touchtechio/spiderdress/eagle/spiderBoardv17-2014-12-18.xls

Bill of Materials - Per Board |  |  |  |  | Customer Info | Matt Pinner | matthewx.pinner@intel.com | Cell: 310-866-0521
Order No |  |  |  |  |  | Attn: Todd Harple
Part No |  | Mpinner-spider-v17 |  |  |  | 2501 NW 229th Ave, RS5-250
 |  |  |  |  |  | Hillsboro, OR, 97124
Item # | Qty | Ref Des | Value | Manufacturer | Mfg Part Num | Distributor | Dist Part # | Description | Package | Type
1 | 1 | R1 | 1k | Vishay Dale | ERJ-3GEYJ102V | Digikey | P1.0KGCT-ND | Resistor | 0603 | smt
2 | 16 | R2,R4,R5,R6,R7,R8,R9,R10,R12,R14,R15,R16,R17,R18,R19,R21 | 10k | Panasonic | ERJ3GEYJ103V | Digikey | P10KGCT-ND | Resistor | 0603 | smt
3 | 1 | C1 | 1uF | Samsung | CL10F105ZP8NNNC | Digikey | 1276-1041-1-ND | Capacitor | 0603 | smt
4 | 1 | U1 | ADS1115 | TI | ADS1115IDGST | Digikey | 296-24934-1-ND | ADC_ADS1015 | MSOP10 | smt
5 | 3 | U2,U3,U4 | DUAL_N-CH_MOSFET | Diodes | BSS138DW-7-F | Digikey | BSS138DW-FDICT-ND | DUAL_N-CH_MOSFET | SOT-363 | smt
6 | 1 | U6 | DNP | intel | na | na | na | na | na | DNP
7 | 4 | U7 | DNP | pololu | 5V_500MA_REG | Pololu | 5V_500MA_REG | 5V_500MA_REG | na | DNP
8 | 1 | U8 | DF40 | hirose | DF40C-70DS-0.4V | Digikey | H11631CT-ND | edison 2mm connector | df40 | smt
 |  |  |  |  |  |  |  | BOARD SUMMARY FOR QUOTE
 |  |  |  |  |  |  |  | Total # of unique parts | 6
 |  |  |  |  |  |  |  | SMT placements per board | 23
 |  |  |  |  |  |  |  | Thru-hole placements per board | 0
 |  |  |  |  |  |  |  | Fine pitch placements per board | 0
 |  |  |  |  |  |  |  | BGA/QFN/Leadless placements per board | 0
 |  |  |  |  |  |  |  | * DNP: Do Not Place
