touchtechio/spiderdress/eagle/buckpuckV5_2014-12-10.brd

## EAGLE design eagle/buckpuckV5_2014-12-10.brd (2015-01-24)

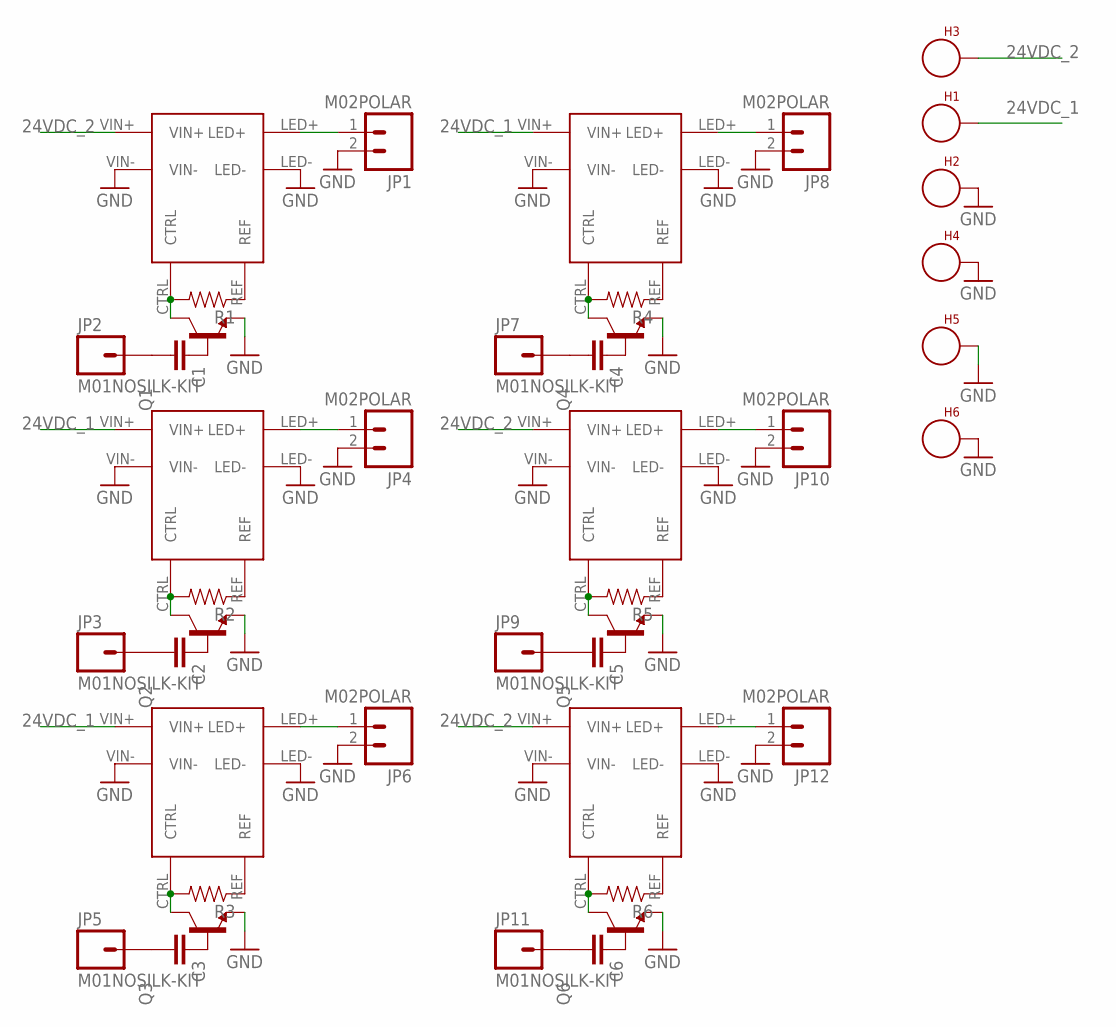
[picture p2: schematic buckpuckV5_2014-12-10.sch]

Parts:
C1, C2, C3, C4, C5, C6: CAPEZ; CAP-PTH-SMALLEZ
H1, H2, H3, H4, H5, H6: SEW_HOLE; SIMPLE_HOLE
JP1, JP4, JP6, JP8, JP10, JP12: M02POLAR; MOLEX-1X2
JP2, JP3, JP5, JP7, JP9, JP11: M01NOSILK-KIT; 1X01NS-KIT
Q1, Q2, Q3, Q4, Q5, Q6: TRANSISTOR_BJT_NPN-TO-92-EBC; TO-92
R1, R2, R3, R4, R5, R6: RESISTOREZ; AXIAL-0.3EZ
U$1, U$2, U$3, U$4, U$5, U$6: BUCKPUCK

Connections:
24VDC_1: H1.P$1, U$2.VIN+, U$3.VIN+, U$4.VIN+
24VDC_2: H3.P$1, U$1.VIN+, U$5.VIN+, U$6.VIN+
GND: H2.P$1, H4.P$1, H5.P$1, H6.P$1, JP1.2, JP4.2, JP6.2, JP8.2, JP10.2, JP12.2, Q1.1 (E), Q2.1 (E), Q3.1 (E), Q4.1 (E), Q5.1 (E), Q6.1 (E), U$1.LED-, U$1.VIN-, U$2.LED-, U$2.VIN-, U$3.LED-, U$3.VIN-, U$4.LED-, U$4.VIN-, U$5.LED-, U$5.VIN-, U$6.LED-, U$6.VIN-
unnamed: R1.P$1 (1), U$1.REF
unnamed: Q1.3 (C), R1.P$2 (2), U$1.CTRL
unnamed: C1.1, Q1.2 (B)
unnamed: R4.P$1 (1), U$4.REF
unnamed: JP1.1, U$1.LED+
unnamed: C1.2, JP2.1
unnamed: C2.1, Q2.2 (B)
unnamed: Q2.3 (C), R2.P$2 (2), U$2.CTRL
unnamed: C4.1, Q4.2 (B)
unnamed: C3.1, Q3.2 (B)
unnamed: JP4.1, U$2.LED+
unnamed: C2.2, JP3.1
unnamed: C6.1, Q6.2 (B)
unnamed: Q3.3 (C), R3.P$2 (2), U$3.CTRL
unnamed: Q4.3 (C), R4.P$2 (2), U$4.CTRL
unnamed: JP6.1, U$3.LED+
unnamed: C3.2, JP5.1
unnamed: R2.P$1 (1), U$2.REF
unnamed: C5.1, Q5.2 (B)
unnamed: R5.P$1 (1), U$5.REF
unnamed: R3.P$1 (1), U$3.REF
unnamed: JP8.1, U$4.LED+
unnamed: C4.2, JP7.1
unnamed: R6.P$1 (1), U$6.REF
unnamed: Q5.3 (C), R5.P$2 (2), U$5.CTRL
unnamed: JP10.1, U$5.LED+
unnamed: C5.2, JP9.1
unnamed: Q6.3 (C), R6.P$2 (2), U$6.CTRL
unnamed: JP12.1, U$6.LED+
unnamed: C6.2, JP11.1

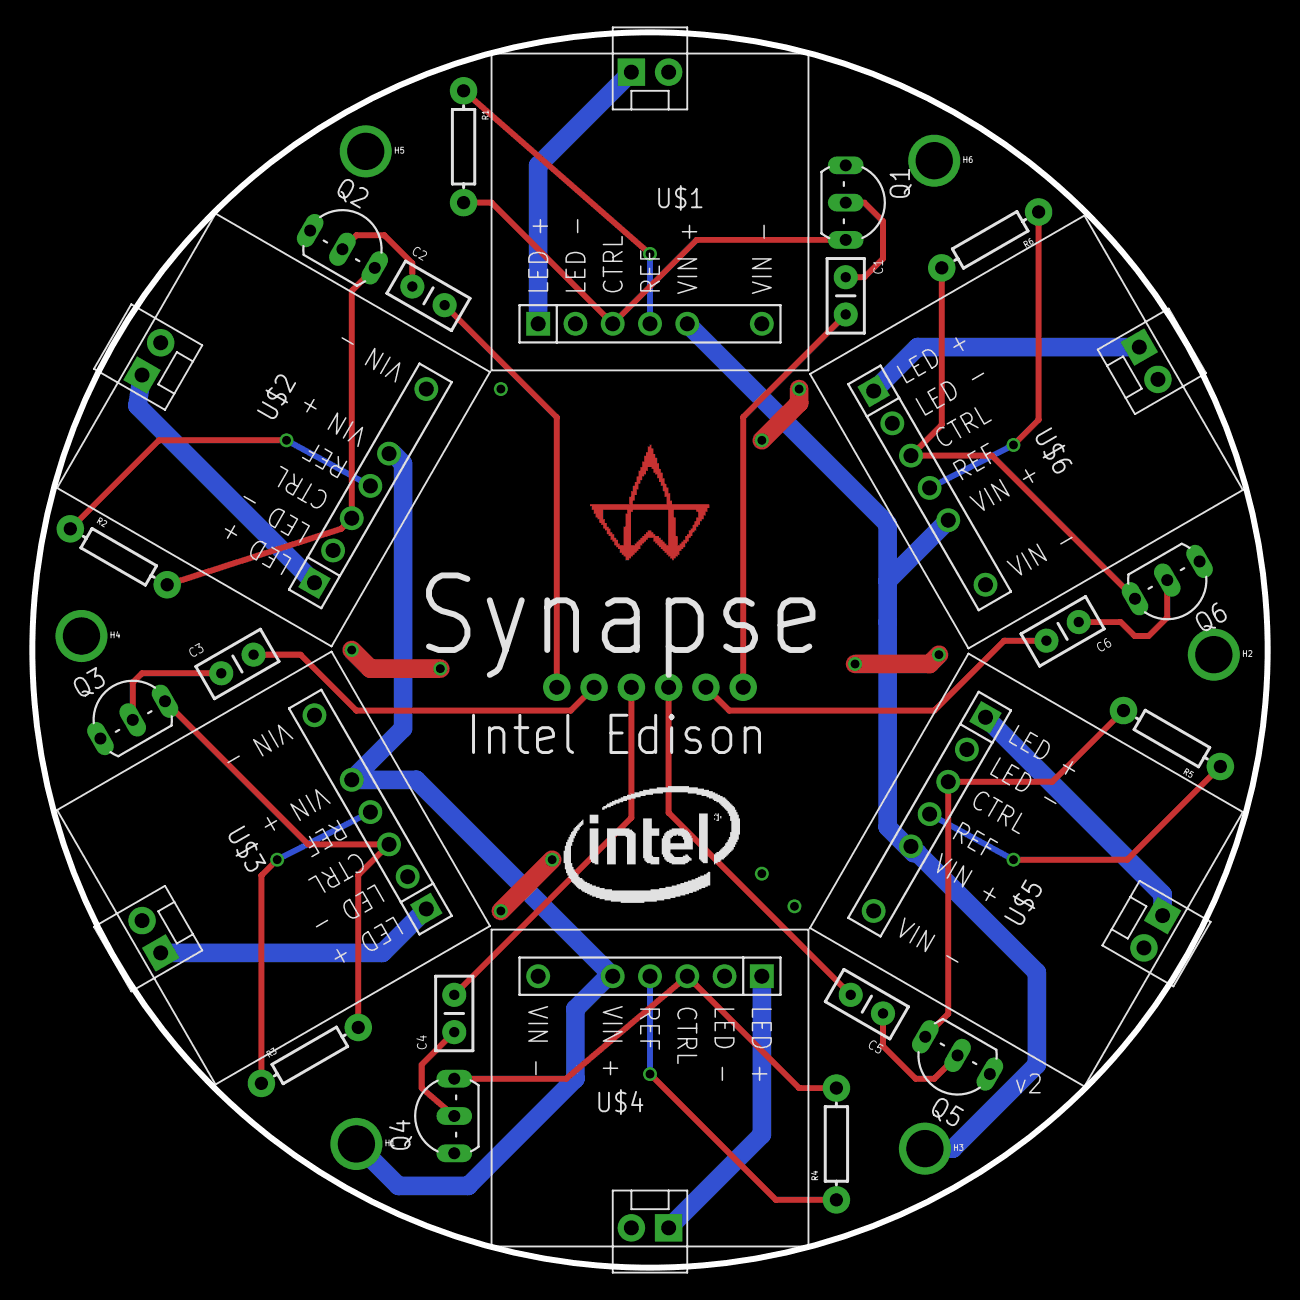
[picture p3: board buckpuckV5_2014-12-10.brd from above]

Board: 2 copper layers, 84.2 x 84.2 mm, 44 parts (1 on the bottom side), 33 nets.

Other parts of the board:
U$7: NOUKLOGO3IN
U$8: NOUKLOGO300MIL_COPPER
