touchtechio/spiderdress/eagle/spiderBoardv17-2014-12-18.brd

## EAGLE design eagle/spiderBoardv17-2014-12-18.brd (2015-01-24)

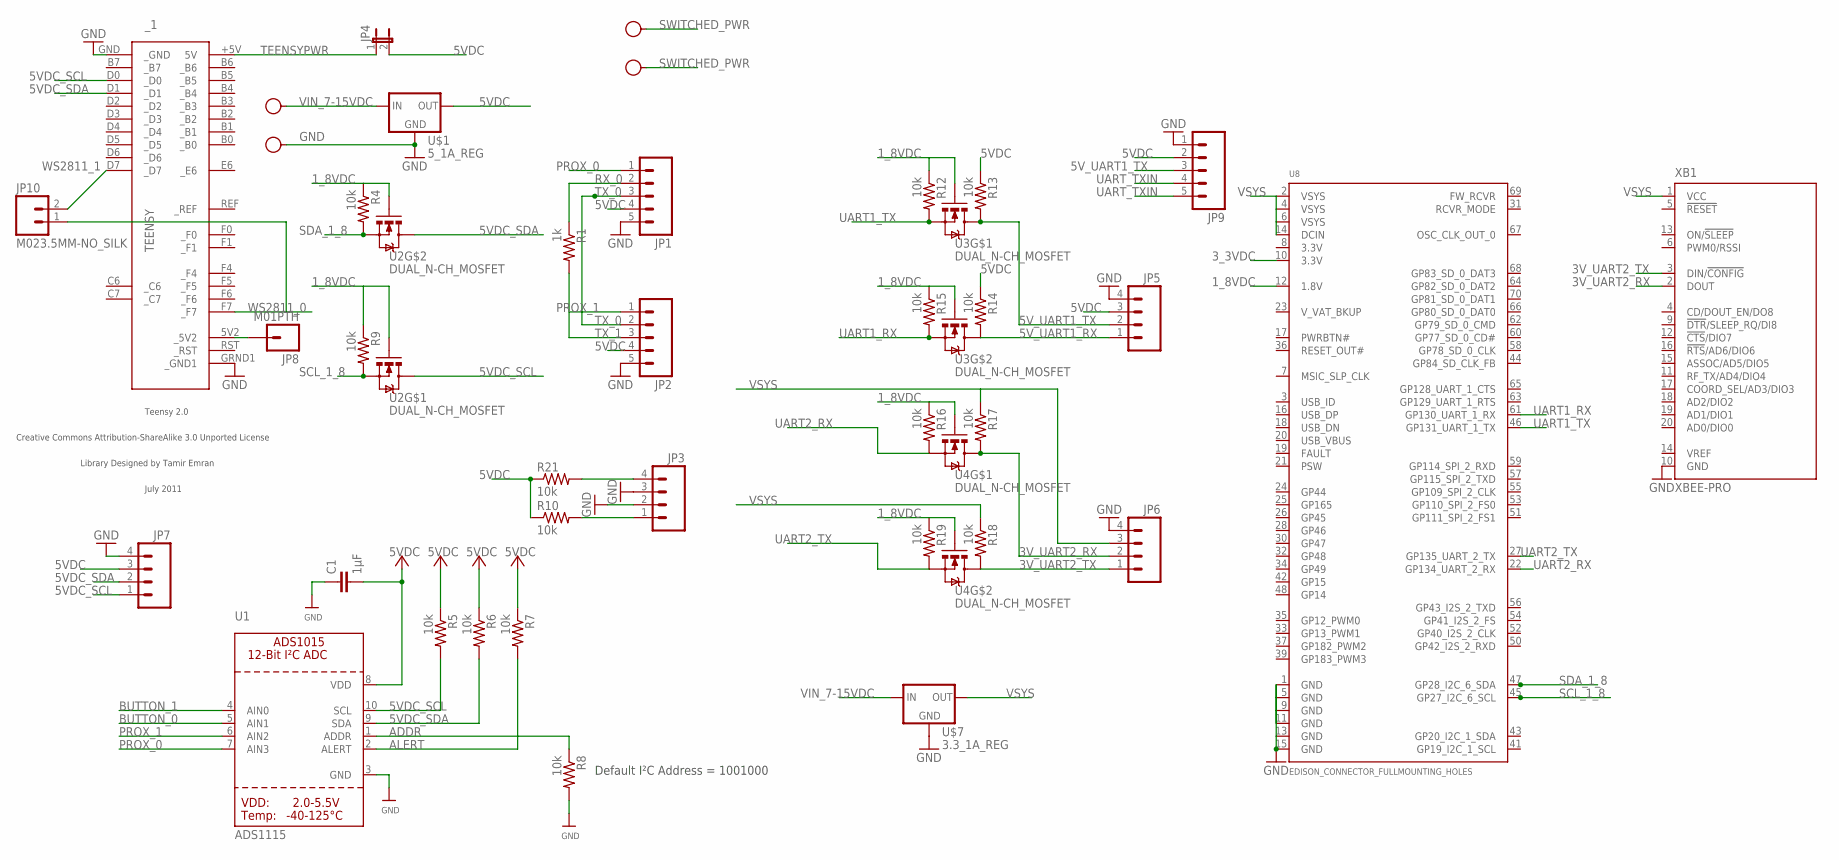
[picture p4: schematic spiderBoardv17-2014-12-18.sch]

Parts:
C1: 1µF; 0603-CAP
GND, GND15: SEW_HOLE-SMALL; SIMPLE_HOLE_SM
JP1, JP2, JP9: M05PTH; 1X05
JP3, JP5, JP6, JP7: M04PTH; 1X04
JP4: JUMPER-2SMD-NC; SJ_2S
JP8: M01PTH; 1X01
JP10: M023.5MM-NO_SILK; SCREWTERMINAL-3.5MM-2-NS
R1: 1k; 0603-RES
R4, R5, R6, R7, R8, R9, R10, R12, R13, R14, R15, R16, R17, R18, R19, R21: 10k; 0603-RES
U1: ADS1115; MSOP10
U2, U3, U4: DUAL_N-CH_MOSFET; SOT363_DUAL_N_MOSFET
U8: EDISON_CONNECTOR_FULLMOUNTING_HOLES; EDISON_DAUGHTER
U$1: 5_1A_REG; 1A_REG
U$7: 3.3_1A_REG; 1A_REG
VIN_7-15VDC, VIN_7-15VDC1: SEW_HOLE-SMALL; SIMPLE_HOLE_SM
XB1: XBEE-PRO
_1: TEENSY

Connections:
1_8VDC: R4.1, R9.1, R12.1, R15.1, R16.1, R19.1, U2.2 (G), U2.5 (G), U3.2 (G), U3.5 (G), U4.2 (G), U4.5 (G), U8.12 (1.8V)
3V_UART2_RX: JP6.2, R17.2, U4.3 (D), XB1.2 (DOUT)
3V_UART2_TX: JP6.1, R18.2, U4.6 (D), XB1.3 (DIN/!CONFIG)
3_3VDC: U8.10 (3.3V)
5VDC: C1.2, JP1.4, JP2.4, JP4.2, JP5.3, JP7.3, JP9.2, R5.1, R6.1, R7.1, R10.1, R13.1, R14.1, R21.1, U1.8 (VDD), U$1.OUT
5VDC_SCL: JP7.1, R5.2, U1.10 (SCL), U2.3 (D), _1.D0 (_D0)
5VDC_SDA: JP7.2, R6.2, U1.9 (SDA), U2.6 (D), _1.D1 (_D1)
5V_UART1_RX: JP5.1, R14.2, U3.6 (D)
5V_UART1_TX: JP5.2, JP9.3, R13.2, U3.3 (D)
ADDR: R8.1, U1.1 (ADDR)
ALERT: R7.2, U1.2 (ALERT)
BUTTON_0: JP3.4, R21.2, U1.5 (AIN1)
BUTTON_1: JP3.1, R10.2, U1.4 (AIN0)
GND: C1.1, GND.P$1, JP1.5, JP2.5, JP3.2, JP3.3, JP5.4, JP6.4, JP7.4, JP9.1, R8.2, U1.3 (GND), U8.1 (GND), U8.5 (GND), U8.9 (GND), U8.11 (GND), U8.13 (GND), U8.15 (GND), U$1.GND, U$7.GND, XB1.10 (GND), _1.GND (_GND), _1.GRND1 (_GND1)
PROX_0: JP1.1, U1.7 (AIN3)
PROX_1: JP2.1, U1.6 (AIN2)
RX_0: JP1.2, R1.1
SCL_1_8: R9.2, U2.4 (S), U8.45 (GP27_I2C_6_SCL)
SDA_1_8: R4.2, U2.1 (S), U8.47 (GP28_I2C_6_SDA)
SWITCHED_PWR: GND15.P$1, VIN_7-15VDC1.P$1
TEENSYPWR: JP4.1, JP8.1, _1.5V2 (_5V2), _1.+5V (5V)
TX_0: JP1.3, JP2.2
TX_1: JP2.3, R1.2
UART1_RX: R15.2, U3.1 (S), U8.61 (GP130_UART_1_RX)
UART1_TX: R12.2, U3.4 (S), U8.46 (GP131_UART_1_TX)
UART2_RX: R16.2, U4.4 (S), U8.22 (GP134_UART_2_RX)
UART2_TX: R19.2, U4.1 (S), U8.27 (GP135_UART_2_TX)
UART_TXIN: JP9.4, JP9.5
VIN_7-15VDC: U$1.IN, U$7.IN, VIN_7-15VDC.P$1
VSYS: JP6.3, R17.1, R18.1, U8.2 (VSYS), U8.4 (VSYS), U8.6 (VSYS), U8.14 (DCIN), U$7.OUT, XB1.1 (VCC)
WS2811_0: JP10.1, _1.F7 (_F7)
WS2811_1: JP10.2, _1.D7 (_D7)

Notes on the sheet:
Default I²C Address = 1001000

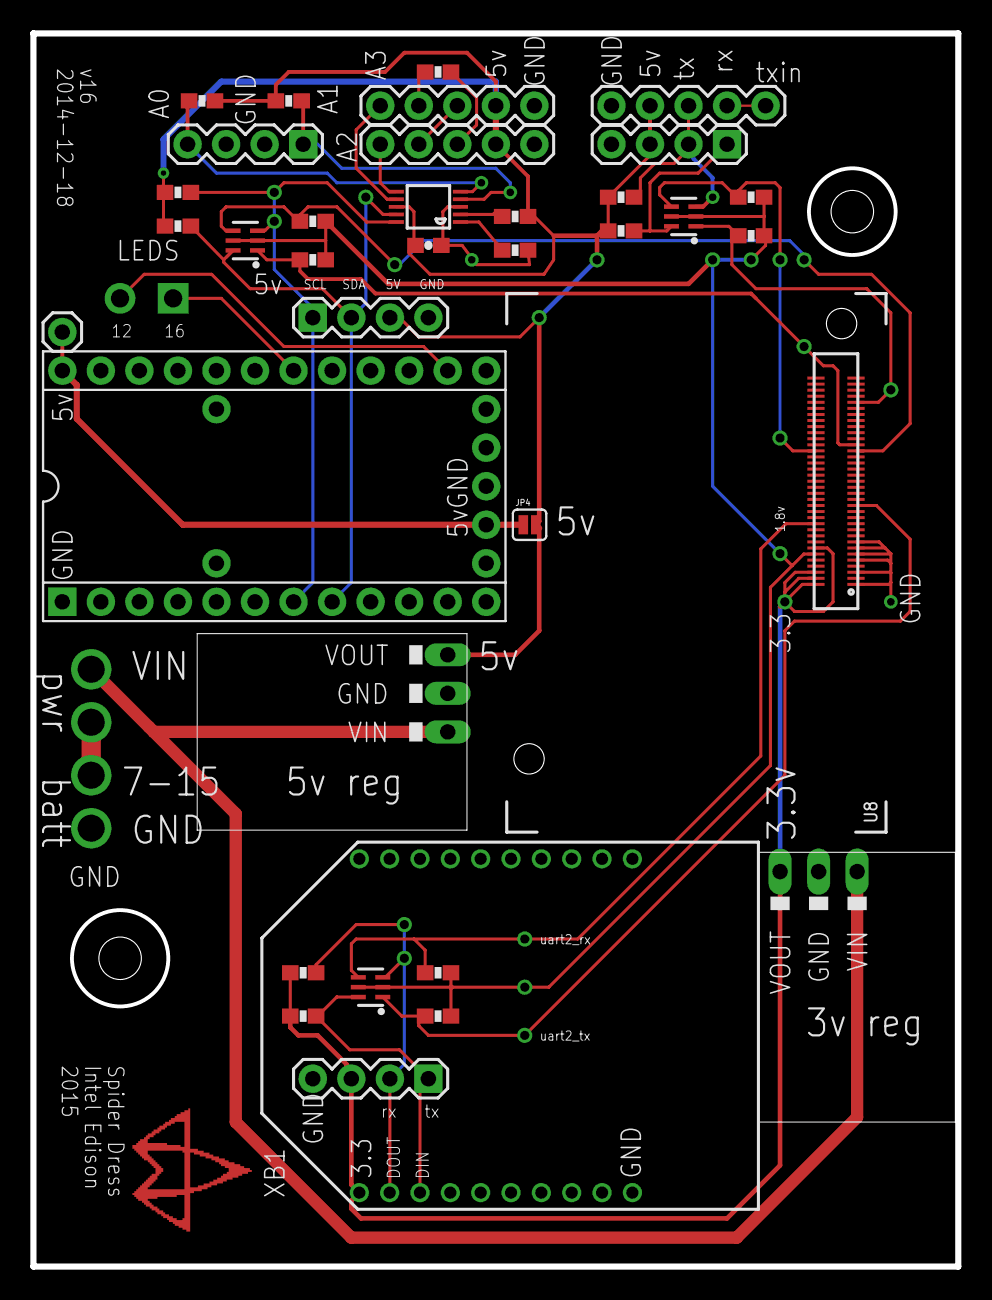
[picture p5: board spiderBoardv17-2014-12-18.brd from above]

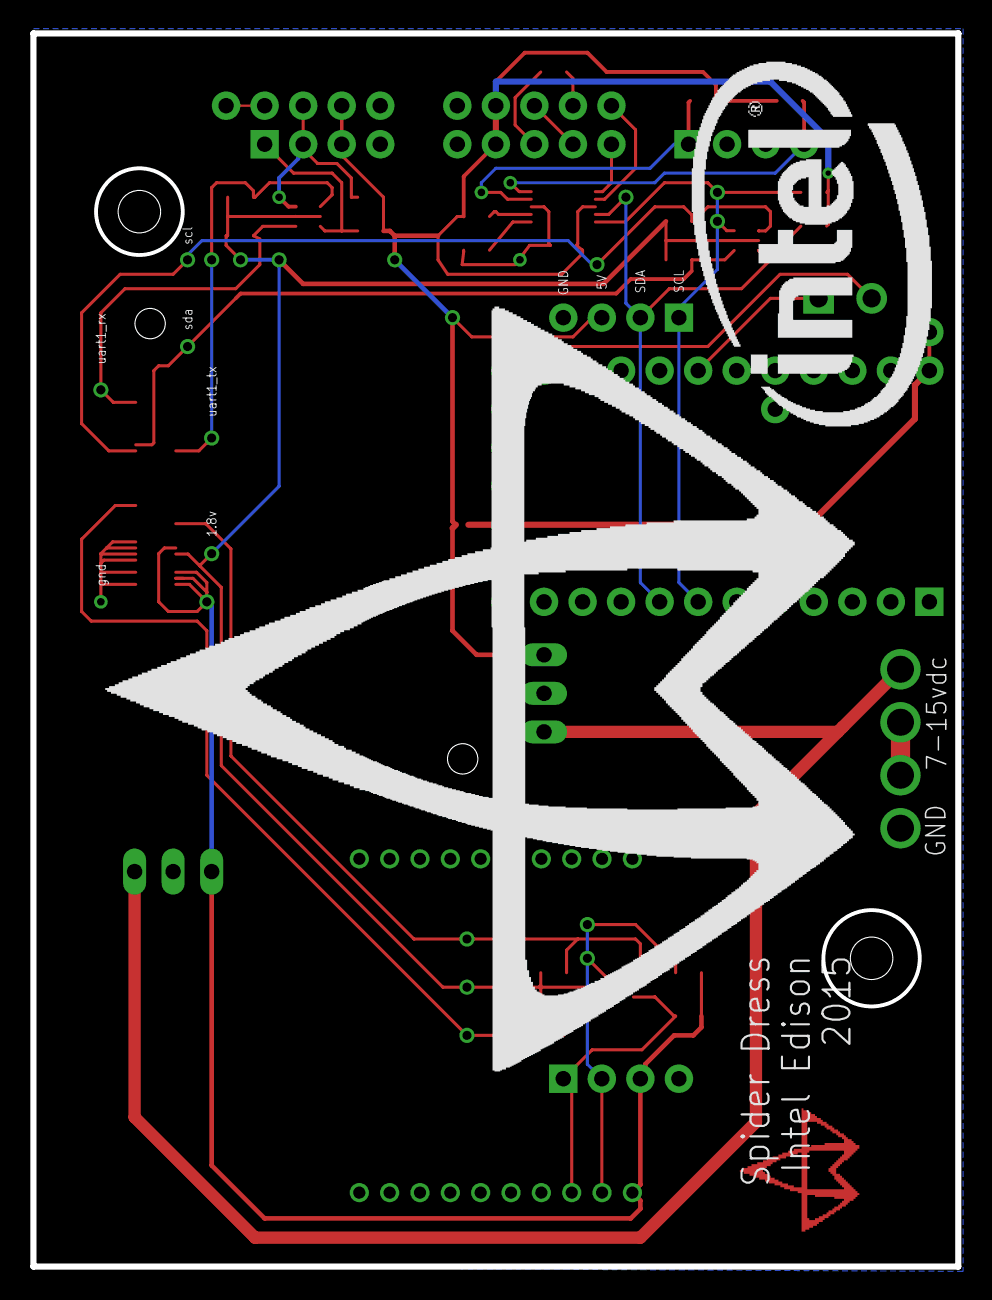
[picture p6: board spiderBoardv17-2014-12-18.brd from below]

Board: 2 copper layers, 61.0 x 81.3 mm, 44 parts (2 on the bottom side), 31 nets.

Other parts of the board:
U$9: NOUK-800
U$11: NOUKLOGO300MIL_COPPER
U$12: INTEL_1IN
