touchtechio/spiderdress/eagle/commonBoard.brd

## EAGLE design eagle/commonBoard.brd (2014-11-17)

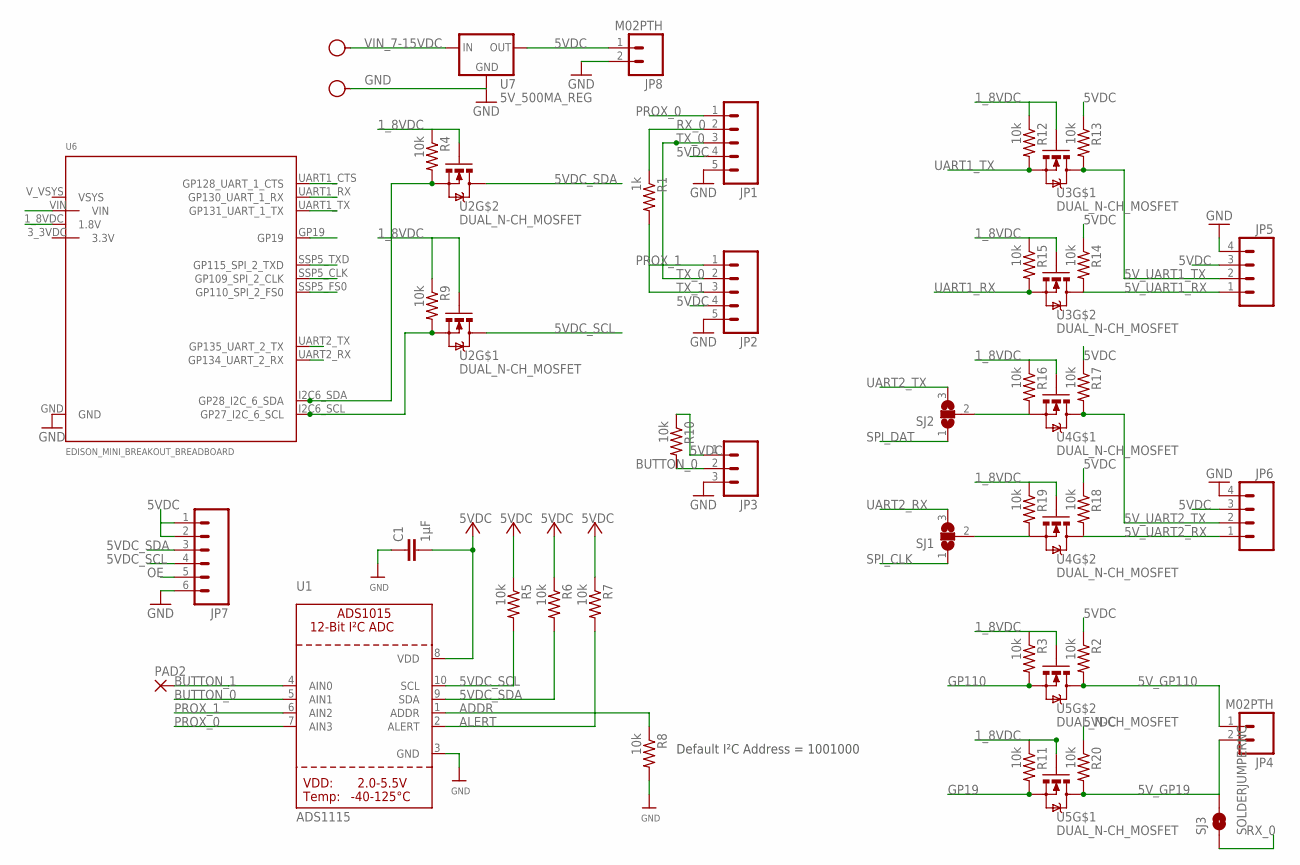
[picture p7: schematic commonBoard.sch]

Parts:
C1: 1µF; 0603-CAP
GND: SEW_HOLE-SMALL; SIMPLE_HOLE_SM
JP1, JP2: M05PTH; 1X05
JP3: M03PTH; 1X03
JP4, JP8: M02PTH; 1X02
JP5, JP6: M04PTH; 1X04
JP7: M06SIP; 1X06
PAD2: 2,15/1,0
R1: 1k; 0603-RES
R2, R3, R4, R5, R6, R7, R8, R9, R10, R11, R12, R13, R14, R15, R16, R17, R18, R19, R20: 10k; 0603-RES
SJ1, SJ2: SJ2W; SJ_2
SJ3: SOLDERJUMPERNC; SJ_2S
U1: ADS1115; MSOP10
U2, U3, U4, U5: DUAL_N-CH_MOSFET; SOT363_DUAL_N_MOSFET
U6: EDISON_MINI_BREAKOUT_BREADBOARD; EDISON_MINI_BREAK_BREADBOARD
U7: 5V_500MA_REG
VIN_7-15VDC: SEW_HOLE-SMALL; SIMPLE_HOLE_SM

Connections:
1_8VDC: R3.1, R4.1, R9.1, R11.1, R12.1, R15.1, R16.1, R19.1, U2.2 (G), U2.5 (G), U3.2 (G), U3.5 (G), U4.2 (G), U4.5 (G), U5.2 (G), U5.5 (G), U6.1_8VDC (1.8V)
5VDC: C1.2, JP1.4, JP2.4, JP3.1, JP5.3, JP6.3, JP7.1, JP7.2, JP8.1, R2.1, R5.1, R6.1, R7.1, R10.1, R13.1, R14.1, R17.1, R18.1, R20.1, U1.8 (VDD), U7.OUT
5VDC_SCL: JP7.4, R5.2, U1.10 (SCL), U2.3 (D)
5VDC_SDA: JP7.3, R6.2, U1.9 (SDA), U2.6 (D)
5V_GP19: JP4.2, R20.2, SJ3.2, U5.3 (D)
5V_GP110: JP4.1, R2.2, U5.6 (D)
5V_UART1_RX: JP5.1, R14.2, U3.6 (D)
5V_UART1_TX: JP5.2, R13.2, U3.3 (D)
5V_UART2_RX: JP6.1, R18.2, U4.6 (D)
5V_UART2_TX: JP6.2, R17.2, U4.3 (D)
ADDR: R8.1, U1.1 (ADDR)
ALERT: R7.2, U1.2 (ALERT)
BUTTON_0: JP3.2, R10.2, U1.5 (AIN1)
BUTTON_1: PAD2.1, U1.4 (AIN0)
GND: C1.1, GND.P$1, JP1.5, JP2.5, JP3.3, JP5.4, JP6.4, JP7.6, JP8.2, R8.2, U1.3 (GND), U6.GND, U7.GND
GP19: R11.2, U5.4 (S), U6.GP19
GP110: R3.2, U5.1 (S), U6.SSP5_FS0 (GP110_SPI_2_FS0)
unnamed: R9.2, U2.4 (S), U6.I2C6_SCL (GP27_I2C_6_SCL)
unnamed: R4.2, U2.1 (S), U6.I2C6_SDA (GP28_I2C_6_SDA)
OE: JP7.5
P1: R16.2, SJ2.2, U4.4 (S)
P2: R19.2, SJ1.2, U4.1 (S)
PROX_0: JP1.1, U1.7 (AIN3)
PROX_1: JP2.1, U1.6 (AIN2)
RX_0: JP1.2, R1.1, SJ3.1
SPI_CLK: SJ1.1, U6.SSP5_CLK (GP109_SPI_2_CLK)
SPI_DAT: SJ2.1, U6.SSP5_TXD (GP115_SPI_2_TXD)
TX_0: JP1.3, JP2.2
TX_1: JP2.3, R1.2
UART1_RX: R15.2, U3.1 (S), U6.UART1_RX (GP130_UART_1_RX)
UART1_TX: R12.2, U3.4 (S), U6.UART1_TX (GP131_UART_1_TX)
UART2_RX: SJ1.3, U6.UART2_RX (GP134_UART_2_RX)
UART2_TX: SJ2.3, U6.UART2_TX (GP135_UART_2_TX)
VIN_7-15VDC: U6.VIN, U7.IN, VIN_7-15VDC.P$1

Notes on the sheet:
Default I²C Address = 1001000

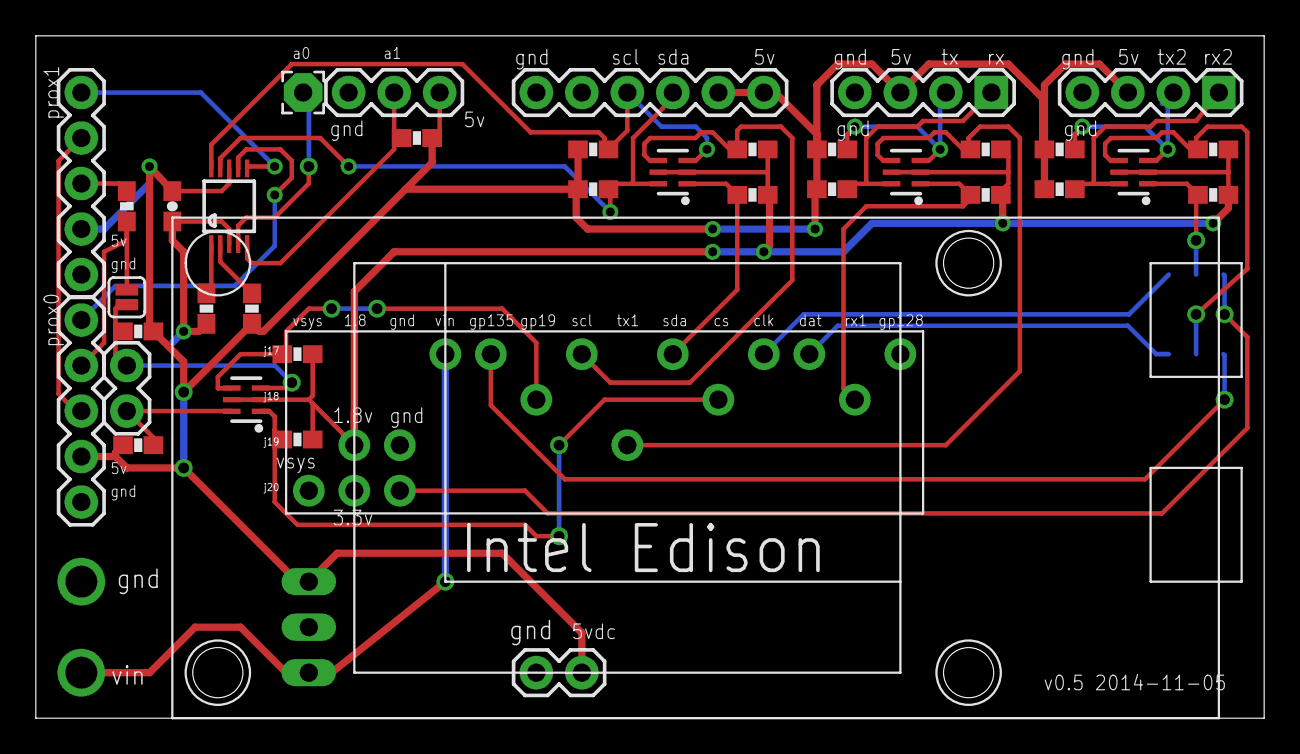
[picture p8: board commonBoard.brd from above]

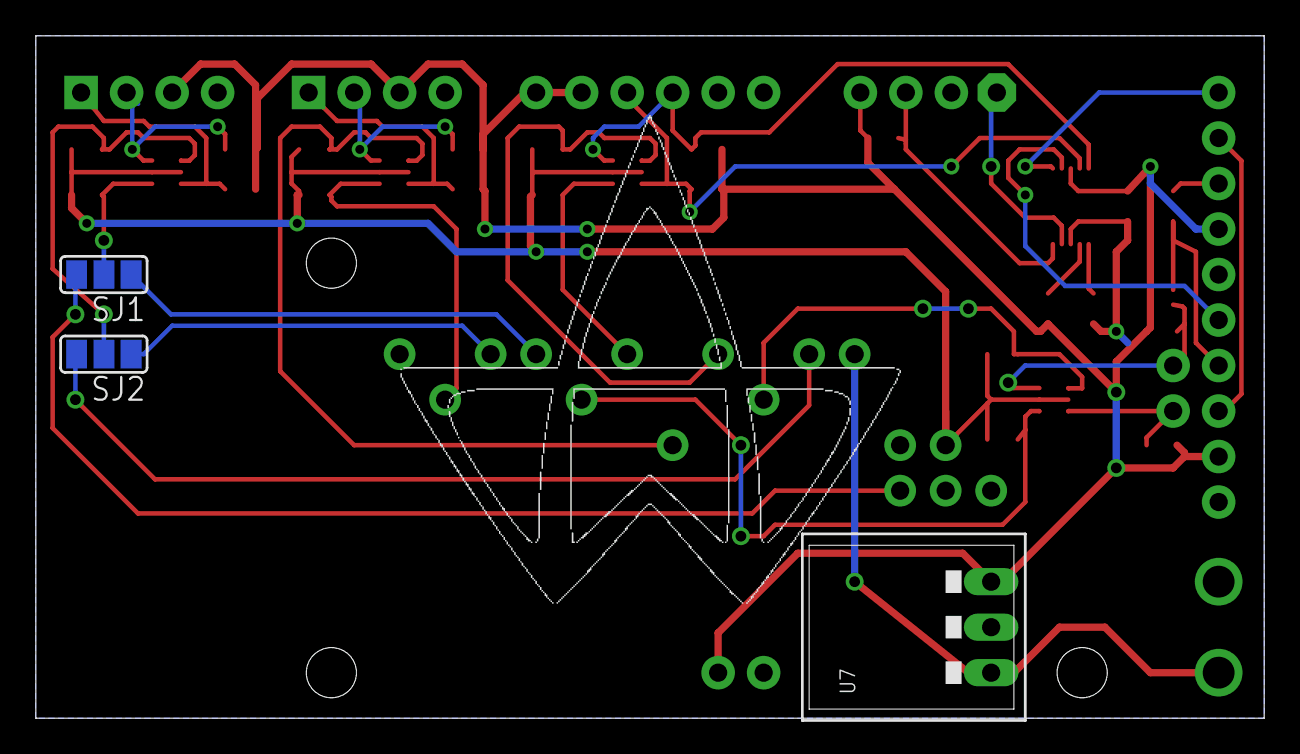
[picture p9: board commonBoard.brd from below]

Board: 2 copper layers, 68.6 x 38.1 mm, 42 parts (3 on the bottom side), 33 nets.
