touchtechio/spiderdress/spider/Servo_Example.py

#!/usr/bin/python

from edi2c import pca9685 as PWM
import time

# ===========================================================================
# Example Code
# ===========================================================================

# Initialise the PWM device using the default address
# bmp = PWM(0x40, debug=True)
pwm = PWM.PCA9685()

servoMin = 150  # Min pulse length out of 4096
servoMax = 600  # Max pulse length out of 4096

def setServoPulse(channel, pulse):
  pulseLength = 1000000                   # 1,000,000 us per second
  pulseLength /= 60                       # 60 Hz
  print "%d us per period" % pulseLength
  pulseLength /= 4096                     # 12 bits of resolution
  print "%d us per bit" % pulseLength
  pulse *= 1000
  pulse /= pulseLength
  pwm.setPWM(channel, 0, pulse)

pwm.set_frequency(60)                        # Set frequency to 60 Hz
while (True):
  # Change speed of continuous servo on channel O
  pwm.set(15, 0, servoMin)
  time.sleep(1)
  pwm.set(15, 0, servoMax)
  time.sleep(1)
