touchtechio/spiderdress/(commit log)

2014-10-14 initial add of servo scripts for testing servos
2014-10-24 initial add of basic functionality for controlling a servo using maestro
2014-10-24 adding command line interface for testing servos
2014-10-24 added ability to get servo position through interactive shell
2014-10-25 Add ability to drive multiple servos through single command in both maestro_controller.py and spider.py.
2014-11-10 custom circuit board sent to fab : https://confluence.ndg.intel.com/display/SYN/Custom+PCB
    [commonBoardPtV0.5-2014-11-05.brd, commonBoardPtV0.5-2014-11-05.sch, mpinner-bom-v0.5-2014-11-05.xlsx]
2014-11-13 Changed set_position to use a different safe servo range. Removed MiniSSC protocol function.
2014-11-13 Fix documentation on set_position function.
    [spider.py]
2014-11-13 teensy and test client for i2c device to paint leds
2014-11-13 adding working copy of custom boards incase there is a revision
    [commonBoard.brd, commonBoard.sch]
2014-11-13 added for completeness
    [bom-v0.5-2014-11-05.xlsx]
2014-11-15 Set single servo command will now work with two chained Maestro controllers.
2014-11-17 Concurrent ADC support with test script.
2014-11-18 Set multiple targets working with chaining. Fixed bug in set single target with chaining.
    [maestro_controller.py]
2014-11-19 updated teensy script for our spider board (and moved)
2014-11-20 Implements servo script and leg abstractions.
2014-11-21 implements protocol for controlling teensy from edison
2014-11-21 rm extra teensy_tester.py
2014-11-22 adds first attempt at proximity teensy hook improves toggling between animations
2014-11-23 Bug fixes set_accel, set_speed, set_position_multiple. Add script for park and extend for four legs.
    [maestro_controller.py]
2014-11-24 Bug fix for running scripts.
    [spider.py]
2014-11-24 Bug fixes for maestro controller, add function to determine movement state of servos, setup park and extend positions for all legs.
    [maestro_controller.py]
2014-11-24 Fix servos moving bug, add Monday servo script.
    [maestro_controller.py]
2014-12-04 disco bug fix attempt
    [i2c_slave_led_receiver.ino]
2014-12-04 Add new publish-subscribe system intended for sensor/servo/LED integration.
2014-12-04 fixes disco and io write errors Please enter the commit message for your changes. Lines starting
    [i2c_slave_led_receiver.ino]
2014-12-08 adding to test leds with spider teensy
2014-12-13 Fix "default" script, an initialization fix for starting leg position.
    [maestro_controller.py]
2014-12-16 Don't exit when resetting PWM
    [pca9685.py]
2014-12-18 Fix animation bug, add servo values for several new positions.
    [maestro_controller.py, spider.py]
2014-12-18 Fix spider.py to conform to new animate function.
    [spider.py]
2014-12-19 Work around for some maestro read issues.
    [maestro_controller.py]
2014-12-23 Adds animations zones, read positions from file, get errors over UART, bug in get position code fix.
    [maestro_controller.py, spider.py]
2014-12-23 Initial integration commit for prox+servos.
2014-12-23 Simple animation based on proximity. Adds teensy+prox interaction.
2014-12-23 Adds ability to disable maestro pulse to all servos.
2014-12-24 Sticky prox space fix.
    [proximity.py]
2014-12-24 Fix to personal animation space.
    [maestro_controller.py]
2014-12-24 Tweaks to animation/prox/respiration interaction. Fix push_away position values.
    [maestro_controller.py]
2014-12-27 Adds button support for two separate CES modes, one with all interaction, the other with only slow breathe. Old spider.py now spider_command, with new spider.py intended to be run and not interacted 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
2014-12-29 Tweak servo positions for dress b.
2014-12-29 spider_command takes a leg file in it's command line arguments.
2014-12-30 Fixes bug in button press code, allowing modes to change correctly.
    [spider.py]
2015-01-04 New servo requires new position data.
2015-01-04 Add new button mode, fix spider_command set multiple servos.
    [spider.py, spider_command.py]
2015-01-04 Clear errors when MaestroController starts.
    [maestro_controller.py]
2015-01-06 Respiration calibration for Whitney.
2015-01-06 Changes the way the modes flow when button is pressed.
2015-01-08 New servo positions for replaced servo.
2015-01-09 New positions for 3 new servos.
2015-01-22 hacked up the maestro init for use on mac for testing and direct servo calibration. //todo: better encapsulation
2015-01-24 adding shell board
    [spiderBoardv17-2014-12-18.brd, spiderBoardv17-2014-12-18.sch, spiderBoardv17-2014-12-18.xls]
2015-01-24 latest buckpuck boards
    [buckpuckV5_2014-12-10.brd, buckpuckV5_2014-12-10.sch]
